NamDHay/DongTamV2/Hardware/dongtam.kicad_pcb

## KiCad design Hardware/dongtam.kicad_pcb (2023-11-13)

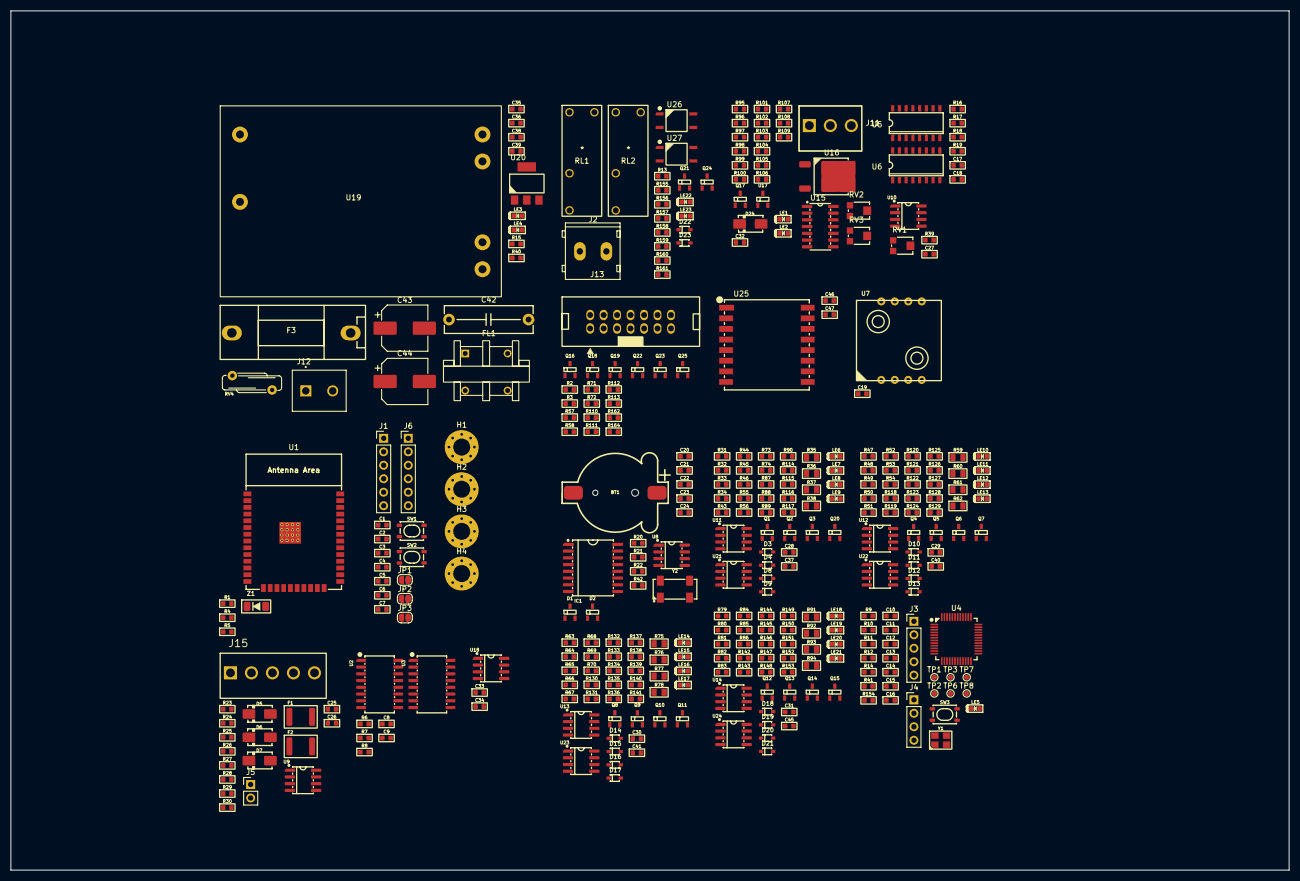
[picture p2: board dongtam.kicad_pcb from above]

Board: 2 copper layers, 241.0 x 162.0 mm, 350 parts (0 on the bottom side), 208 nets, no tracks yet.

Parts:
BT1: CR1220; BatteryHolder_CR1220
C1, C23: 10uF; C_0603
C2, C25, C33, C35, C38, C46: 1uF; C_0603
C3, C6, C7, C8, C9, C13, C14, C15, C16, C17, C18, C19, C22, C24, C26, C27, C28, C29, C30, C31, C32, C34, C36, C37, C39, C40, C41, C45, C47: 100nF; C_0603
C4: 33pF; C_0603
C5, C20, C21: 10pF; C_0603
C10, C11: 22pF; C_0603
C12: 10nF; C_0603
C42: C; C_Rect_L16.5mm_W5.0mm_P15.00mm_MKT
C43, C44: 100uF; CP_Elec_8x10.5
D1, D2: BAT54C; SOT23-3
D3, D4, D8, D9, D10, D11, D12, D13, D14, D15, D16, D17, D18, D19, D20, D21, D22, D23: 1N4007; D_SOD323
D5, D6, D7: D_TVS; D_SMA
D24: 1N4007; D_SMA
F1, F2: Polyfuse; Fuse_1812_4532Metric
F3: Fuse; Fuse_BLX-A-P22.4mm
FL1: Filter_EMI_LL; ACFilterChokeUU9.8
H1, H2, H3, H4: MountingHole; MountingHole_3.2mm_M3_Pad_Via
IC1: RTC_DS3231M; SOIC-16W_7.5x10.3mm_P1.27mm
J1, J6: Conn_01x05_Male; PinHeader_1x06_P2.54mm_Vertical
J2: Conn_01x02_Socket; KF128-5.0-2P
J3: Conn_01x05_Male; PinHeader_1x05_P2.54mm_Vertical
J4: Conn_01x04_Male; PinHeader_1x04_P2.54mm_Vertical
J5: Conn_01x02_Male; PinHeader_1x02_P2.54mm_Vertical
J11: HT3.96mm-3P; Terminal_HT-P3.96mm-3P-Vertical-Pluggable
J12: HT-5.08mm; KF-5.08mm
J13: IDC_02x07; DC3_14PIN_2.54mm
J15: Conn_01x05_Pin; Terminal_HT-3.96mm-5P-Vertical-Pluggable
JP1, JP2, JP3: SolderJumper-2_P1.3mm_Open_RoundedPad1.0x1.5mm
LE1, LE2, LE3, LE4, LE5, LE6, LE7, LE8, LE9, LE10, LE11, LE12, LE13, LE14, LE15, LE16, LE17, LE18, LE19, LE20, LE21, LE22, LE23: Led; LED_0603
Q1, Q2, Q3, Q4, Q5, Q6, Q7, Q8, Q9, Q10, Q11, Q12, Q13, Q14, Q15, Q16, Q18, Q19, Q20, Q21, Q22, Q23, Q24, Q25: N_Mosfet; SOT23-3
Q17: NPN; SOT23-3
R1: 100; R_0603
R2, R3, R6, R7, R8, R10, R11, R16, R17, R18, R19, R57, R58, R71, R72, R110, R111, R112, R113, R162, R164: 4k7; R_0603
R4, R5, R9, R15, R25, R26, R44, R46, R73, R87, R97, R118, R120, R122, R124, R130, R132, R134, R136, R142, R144, R146, R148: 10k; R_0603
R12: 2k2; R_0603
R13, R39, R40, R42, R43, R45, R47, R48, R49, R50, R55, R56, R63, R64, R65, R66, R74, R79, R80, R81, R82, R88, R89, R90, R96, R114, R115, R116, R117, R119, R121, R123, R125, R126, R127, R128, R129, R131, R133, R135, R137, R138, R139, R140, R141, R143, R145, R147, R149, R150, R151, R152, R153, R157: 1k; R_0603
R14, R154: 10K; R_0603
R20, R22: NC; R_0603
R21: 0R; R_0603
R23, R24, R27, R28, R29: 120R; R_0603
R30, R31, R32, R33, R34, R41, R51, R52, R53, R54, R67, R68, R69, R70, R83, R84, R85, R86, R155, R156: 1M; R_0603
R35, R36, R37, R38, R59, R60, R61, R62, R75, R76, R77, R78, R91, R92, R93, R94: 0R5; R_0805
R95: 220R; R_0603
R98: 560R; R_0603
R99, R100: 100k; R_0603
R101, R102, R103, R104, R105, R106, R109: 820k; R_0603
R107: 100R; R_0603
R108: 680k; R_0603
R158, R161: 5k; R_0603
R159, R160: R; R_0603
RL1, RL2: Relay_G5NB-1A-E_DC5; Relay_G5NB-1A-E DC5
RV1: TC33X_10k; Potentiometer_Bourns_TC33X_Vertical
RV2, RV3: 100k; Potentiometer_Bourns_TC33X_Vertical
RV4: Varistor; RV_Disc_D12mm_W5.8mm_P7.5mm
SW1, SW2, SW3: SW_Push; SW_SPST_PTS810
TP1, TP2, TP3, TP6, TP7, TP8: TestPoint; TestPoint_Pad_D1.0mm
U1: ESP32-WROOM-32UE; ESP32-WROOM-32E
U2, U3: 74HC165; SOIC-16W_5.3x10.2mm_P1.27mm
U4: STM32F103C8Tx; LQFP-48_7x7mm_P0.5mm
U5, U6: 74HC595; SOIC-16W_3.92x10.2mm
U7: AMS5915
U8: PCF8563TS; SOIC-8_3.9x4.9mm_P1.27mm
U9: SP3485EN; SOIC-8_3.9x4.9mm_P1.27mm
U10: MCP41010; SOIC-8_3.9x4.9mm_P1.27mm
U11, U12, U13, U14, U21, U22, U23, U24: LM393; SOIC-8_3.9x4.9mm_P1.27mm
U15: LM324; SOIC14
U16: LM317_TO-252; TO-252-2
U17: TL431; SOT23-3
U18: 24LC256; SOIC-8_3.9x4.9mm_P1.27mm
U19: AM22-24W2405V; DualPowerSupply_AM22-24W2405V
U20: LD1117; SOT233
U25: Ai-Thinker-Ra-02; MODULE_RA-02_LORA
U26, U27: Opto; OPTO_EL357N-G
Y1: 8MHz; Crystal_3225_4P_3.2x2.6mm
Y2: 32.768kHz; Crystal_MC306
Z1: D_Zener; D_MiniMELF

Connections:
+3V3: C8.2, C9.2, C13.1, C14.1, C15.1, C16.1, C19.2, C23.2, C24.2, C25.2, C27.1, C28.1, C29.1, C30.1, C31.1, C33.1, C34.1, C37.1, C38.2, C39.2, C40.1, C41.1, C45.1, C46.1, C47.1, D2.1, IC1.2 (VCC), J1.6, J3.4, J4.3, J6.6, J13.13, JP1.1 (A), LE5.1, Q16.1 (G), Q18.1 (G), Q19.1 (G), Q22.1 (G), Q23.1 (G), Q25.1 (G), R3.1, R4.1, R5.1, R6.1, R7.1, R8.1, R9.1, R10.1, R11.1, R26.1, R42.1, R44.1, R45.2, R46.1, R56.2, R57.1, R58.1, R73.1, R87.1, R89.2, R90.2, R110.1, R111.1, R118.1, R120.1, R122.1, R124.1, R126.2, R127.2, R128.2, R129.2, R130.1, R132.1, R134.1, R136.1, R138.2, R139.2, R140.2, R141.2, R142.1, R144.1, R146.1, R148.1, R150.2, R151.2, R152.2, R153.2, R159.2, R160.2, R162.1, RV1.3, U2.16 (VCC), U3.16 (VCC), U4.9 (VDDA), U4.24 (VDD), U4.36 (VDD), U4.48 (VDD), U7.2 (VCC), U9.8 (VCC), U10.5 (PA0), U10.8 (VDD), U11.8 (V+), U12.8 (V+), U13.8 (V+), U14.8 (V+), U18.8 (VCC), U20.2 (VO), U21.8 (V+), U22.8 (V+), U23.8 (V+), U24.8 (V+), U25.3 (VDD)
+5V: C17.2, C18.2, C35.2, C36.2, C44.1, D22.2, D23.2, J3.5, J13.2, R2.1, R16.1, R17.1, R18.1, R19.1, R22.1, R40.1, R71.1, R72.1, R112.1, R113.1, R157.1, R164.1, RL2.1, U5.10 (~SRCLR), U5.16 (VCC), U6.10 (~SRCLR), U6.16 (VCC), U19.6 (+5V), U20.3 (VI)
+24V: C43.1, D3.2, D4.2, D8.2, D9.2, D10.2, D11.2, D12.2, D13.2, D14.2, D15.2, D16.2, D17.2, D18.2, D19.2, D20.2, D21.2, R15.1, U19.3 (+24V)
/4-20mAConverter/DAC_4_20mA: R99.1, U1.10 (IO25), U15.3 (+)
/4-20mAConverter/LM137_IN: C32.1, D24.2, Q17.3 (C), U15.4 (V+), U16.3 (VI)
/4-20mAConverter/LM137_OUT: R95.1, R97.1, R98.2, U16.2 (VO)
/4-20mAConverter/TransB: Q17.1 (B), U15.8
/16_VALVE_CONTROL/595.RCLK: R19.2, U4.18 (PB0), U5.12 (RCLK), U6.12 (RCLK)
/16_VALVE_CONTROL/595.SER: R18.2, U4.17 (PA7), U5.14 (SER)
/16_VALVE_CONTROL/595.SRCLK: R17.2, U4.15 (PA5), U5.11 (SRCLK), U6.11 (SRCLK)
/16_VALVE_CONTROL/OE: R16.2, U2.15 (~CE), U3.15 (~CE), U4.33 (PA12), U5.13 (~OE), U6.13 (~OE)
/16_VALVE_CONTROL/VI_1: Q20.1 (G), R31.1, R114.1, U5.15 (QA)
/16_VALVE_CONTROL/VI_2: Q1.1 (G), R32.1, R115.1, U5.1 (QB)
/16_VALVE_CONTROL/VI_3: Q2.1 (G), R33.1, R116.1, U5.2 (QC)
/16_VALVE_CONTROL/VI_4: Q3.1 (G), R34.1, R117.1, U5.3 (QD)
/16_VALVE_CONTROL/VI_5: Q4.1 (G), R47.1, R51.1, U5.4 (QE)
/16_VALVE_CONTROL/VI_6: Q5.1 (G), R49.1, R52.1, U5.5 (QF)
/16_VALVE_CONTROL/VI_7: Q6.1 (G), R48.1, R53.1, U5.6 (QG)
/16_VALVE_CONTROL/VI_8: Q7.1 (G), R50.1, R54.1, U5.7 (QH)
/16_VALVE_CONTROL/VI_9: Q8.1 (G), R63.1, R67.1, U6.15 (QA)
/16_VALVE_CONTROL/VI_10: Q9.1 (G), R65.1, R68.1, U6.1 (QB)
/16_VALVE_CONTROL/VI_11: Q10.1 (G), R64.1, R69.1, U6.2 (QC)
/16_VALVE_CONTROL/VI_12: Q11.1 (G), R66.1, R70.1, U6.3 (QD)
/16_VALVE_CONTROL/VI_13: Q12.1 (G), R79.1, R83.1, U6.4 (QE)
/16_VALVE_CONTROL/VI_14: Q13.1 (G), R81.1, R84.1, U6.5 (QF)
/16_VALVE_CONTROL/VI_15: Q14.1 (G), R80.1, R85.1, U6.6 (QG)
/16_VALVE_CONTROL/VI_16: Q15.1 (G), R82.1, R86.1, U6.7 (QH)
/EEPROM/24256.SCL: Q19.2 (S), R111.2, U1.36 (IO22), U18.6 (SCL)
/EEPROM/24256.SDA: Q18.2 (S), R110.2, U1.33 (IO21), U18.5 (SDA)
/ESP32/BOOT: C6.1, J1.5, R4.2, SW1.1, U1.25 (IO0)
/ESP32/BT.s1: J13.11, U1.7 (IO35)
/ESP32/BT.s2: J13.9, U1.6 (IO34)
/ESP32/BT.s3: J13.7, U1.5 (SENSOR_VN)
/ESP32/BT.s4: J13.5, U1.4 (SENSOR_VP)
/ESP32/ESP_74595.RCLK: Q22.2 (S), R57.2, U1.29 (IO5)
/ESP32/ESP_74595.SER: Q16.2 (S), R3.2, U1.37 (IO23)
/ESP32/ESP_74595.SRCLK: Q23.2 (S), R58.2, U1.30 (IO18)
/ESP32/RST: C7.1, J1.2, R5.2, SW2.2, U1.3 (EN)
/ESP32/RX: J1.4, U1.34 (RXD0/IO3)
/ESP32/RX_ESP32: JP2.2 (B), U4.30 (PA9)
/ESP32/TCK: J6.4, U1.16 (IO13)
/ESP32/TDI: J6.2, U1.14 (IO12)
/ESP32/TDO: J6.3, U1.23 (IO15)
/ESP32/TMS: J6.5, U1.13 (IO14)
/ESP32/TX: J1.3, U1.35 (TXD0/IO1)
/ESP32/TX_ESP32: JP3.2 (B), U4.31 (PA10)
/ESP32/VDD_ESP32: C1.1, C2.1, C3.1, C4.1, C5.1, JP1.2 (B), U1.2 (VDD), Z1.2
/GET_16_VALVE_STAGE/74HC165.DATA: R6.2, U2.9 (Q7), U4.39 (PB3)
/GET_16_VALVE_STAGE/74HC165.LOAD: R8.2, U2.1 (~PL), U3.1 (~PL), U4.32 (PA11)
/GET_16_VALVE_STAGE/74HC165.SCK: R7.2, U2.2 (CP), U3.2 (CP), U4.40 (PB4)
/GET_16_VALVE_STAGE/MCP41010.CS: U4.25 (PB12), U10.1 (~CS)
/GET_16_VALVE_STAGE/MCP41010.MOSI: U4.28 (PB15), U10.3 (SI), U25.14 (MOSI)
/GET_16_VALVE_STAGE/MCP41010.SCK: U4.26 (PB13), U10.2 (SCK), U25.12 (SCK)
/GET_16_VALVE_STAGE/OPAMP/1_TL084IPT/VAN1-: D8.1, Q20.3 (D)
/GET_16_VALVE_STAGE/OPAMP/1_TL084IPT/VAN2-: D9.1, Q1.3 (D)
/GET_16_VALVE_STAGE/OPAMP/1_TL084IPT/VAN3-: D3.1, Q2.3 (D)
/GET_16_VALVE_STAGE/OPAMP/1_TL084IPT/VAN4-: D4.1, Q3.3 (D)
/GET_16_VALVE_STAGE/OPAMP/2_TL084IPT/VAN1-: D10.1, Q4.3 (D)
/GET_16_VALVE_STAGE/OPAMP/2_TL084IPT/VAN2-: D11.1, Q5.3 (D)
/GET_16_VALVE_STAGE/OPAMP/2_TL084IPT/VAN3-: D12.1, Q6.3 (D)
/GET_16_VALVE_STAGE/OPAMP/2_TL084IPT/VAN4-: D13.1, Q7.3 (D)
/GET_16_VALVE_STAGE/OPAMP/3_TL084IPT/VAN1-: D14.1, Q8.3 (D)
/GET_16_VALVE_STAGE/OPAMP/3_TL084IPT/VAN2-: D15.1, Q9.3 (D)
/GET_16_VALVE_STAGE/OPAMP/3_TL084IPT/VAN3-: D16.1, Q10.3 (D)
/GET_16_VALVE_STAGE/OPAMP/3_TL084IPT/VAN4-: D17.1, Q11.3 (D)
/GET_16_VALVE_STAGE/OPAMP/4_TL084IPT/VAN1-: D18.1, Q12.3 (D)
/GET_16_VALVE_STAGE/OPAMP/4_TL084IPT/VAN2-: D19.1, Q13.3 (D)
/GET_16_VALVE_STAGE/OPAMP/4_TL084IPT/VAN3-: D20.1, Q14.3 (D)
/GET_16_VALVE_STAGE/OPAMP/4_TL084IPT/VAN4-: D21.1, Q15.3 (D)
/GET_16_VALVE_STAGE/OPAMP/PW0_MCP41010: R39.1, R43.1, R44.2, R46.2, R55.1, R73.2, R74.1, R87.2, R88.1, R118.2, R119.1, R120.2, R121.1, R122.2, R123.1, R124.2, R125.1, R130.2, R131.1, R132.2, R133.1, R134.2, R135.1, R136.2, R137.1, R142.2, R143.1, R144.2, R145.1, R146.2, R147.1, R148.2, R149.1, RV1.2, U10.6 (PW0), U11.2 (-), U11.6 (-), U12.2 (-), U12.6 (-), U13.2 (-), U13.6 (-), U14.2 (-), U14.6 (-), U21.2 (-), U21.6 (-), U22.2 (-), U22.6 (-), U23.2 (-), U23.6 (-), U24.2 (-), U24.6 (-)
/GET_16_VALVE_STAGE/OPAMP/VO_1: R56.1, U2.11 (D0), U11.1
/GET_16_VALVE_STAGE/OPAMP/VO_2: R45.1, U2.12 (D1), U11.7
/GET_16_VALVE_STAGE/OPAMP/VO_3: R89.1, U2.13 (D2), U21.1
/GET_16_VALVE_STAGE/OPAMP/VO_4: R90.1, U2.14 (D3), U21.7
/GET_16_VALVE_STAGE/OPAMP/VO_5: R126.1, U2.3 (D4), U12.1
/GET_16_VALVE_STAGE/OPAMP/VO_6: R128.1, U2.4 (D5), U12.7
/GET_16_VALVE_STAGE/OPAMP/VO_7: R127.1, U2.5 (D6), U22.1
/GET_16_VALVE_STAGE/OPAMP/VO_8: R129.1, U2.6 (D7), U22.7
/GET_16_VALVE_STAGE/OPAMP/VO_9: R138.1, U3.11 (D0), U13.1
/GET_16_VALVE_STAGE/OPAMP/VO_10: R140.1, U3.12 (D1), U13.7
/GET_16_VALVE_STAGE/OPAMP/VO_11: R139.1, U3.13 (D2), U23.1
/GET_16_VALVE_STAGE/OPAMP/VO_12: R141.1, U3.14 (D3), U23.7
/GET_16_VALVE_STAGE/OPAMP/VO_13: R150.1, U3.3 (D4), U14.1
/GET_16_VALVE_STAGE/OPAMP/VO_14: R152.1, U3.4 (D5), U14.7
/GET_16_VALVE_STAGE/OPAMP/VO_15: R151.1, U3.5 (D6), U24.1
/GET_16_VALVE_STAGE/OPAMP/VO_16: R153.1, U3.6 (D7), U24.7
/IDC14pin/74595OE: Q25.2 (S), R162.2
/IDC14pin/74595_OE: J13.8, Q25.3 (D), R164.2
/IDC14pin/IC74595_RCLK: J13.10, Q22.3 (D), R71.2
/IDC14pin/IC74595_SER: J13.6, Q16.3 (D), R2.2
/IDC14pin/IC74595_SRCLK: J13.12, Q23.3 (D), R72.2
/IDC14pin/LCD_I2C_LOGIC_SCL: J13.3, Q19.3 (D), R113.2
/IDC14pin/LCD_I2C_LOGIDC_SDA: J13.4, Q18.3 (D), R112.2
/LORA/LORA_CS: U4.27 (PB14), U25.15 (~NSS)
/LORA/LORA_INT: U4.38 (PA15), U25.5 (DIO0)
/LORA/LORA_RST: U4.10 (PA0), U25.4 (~RESET)
/PRESSURE_SENSOR/i2c.SCL: IC1.16 (SCL), R10.2, U4.42 (PB6), U7.4 (SCL), U8.6 (SCL)
/PRESSURE_SENSOR/i2c.SDA: IC1.15 (SDA), R11.2, U4.43 (PB7), U7.3 (SDA), U8.5 (SDA)
/RELAY_OPTO/OPTO1: J2.1, R158.2, R159.1, U26.4
/RELAY_OPTO/OPTO2: J2.2, R160.1, R161.2, U27.4
/RELAY_OPTO/RL1: Q21.1 (G), R155.1
/RELAY_OPTO/RL2: Q24.1 (G), R156.1
/RS485/A1_RS485: D5.2, D6.1, F1.1, R27.2, R29.1
/RS485/A2_RS485: R26.2, R27.1, U9.6 (A)
/RS485/A_RS485: F1.2, J15.4, J15.5
/RS485/B1_RS485: D6.2, D7.1, F2.1, J5.1, R28.2
/RS485/B2_RS485: R25.1, R28.1, U9.7 (B)
/RS485/B_RS485: F2.2, J15.2, J15.3
/RS485/RS485.DERE: U4.11 (PA1), U9.2 (~RE), U9.3 (DE)
/RS485/RS485.RX: R24.1, U4.12 (PA2)
/RS485/RS485.TX: R23.1, U4.13 (PA3)
/RTC/Vbat: BT1.1 (+), D1.2, D2.3, R20.2, R21.1
/STM32F103C8T6/LED: R12.1, U4.19 (PB1)
/STM32F103C8T6/PD0: C10.2, R41.1, U4.5 (PD0), Y1.1
/STM32F103C8T6/PD1: C11.1, R41.2, U4.6 (PD1), Y1.3
/STM32F103C8T6/RST: C12.2, R9.2, SW3.1, U4.7 (NRST)
/STM32F103C8T6/RX_LOG: J4.2, U4.22 (PB11)
/STM32F103C8T6/SWCLK: J3.1, U4.37 (PA14)
/STM32F103C8T6/SWDIO: J3.2, U4.34 (PA13)
/STM32F103C8T6/TX_LOG: J4.1, U4.21 (PB10)
Earth: C26.1, J15.1, R30.1
GND: BT1.2 (-), C1.2, C2.2, C3.2, C4.2, C5.2, C6.2, C7.2, C8.1, C9.1, C10.1, C11.2, C12.1, C13.2, C14.2, C15.2, C16.2, C17.1, C18.1, C19.1, C20.2, C21.2, C22.2, C23.1, C24.1, C25.1, C26.2, C27.2, C28.2, C29.2, C30.2, C31.2, C32.2, C33.2, C34.2, C35.1, C36.1, C37.2, C38.1, C39.1, C40.2, C41.2, C43.2, C44.2, C45.2, C46.2, C47.2, D5.1, D7.2, IC1.5 (GND), IC1.6 (GND), IC1.7 (GND), IC1.8 (GND), IC1.9 (GND), IC1.10 (GND), IC1.11 (GND), IC1.12 (GND), IC1.13 (GND), J1.1, J3.3, J4.4, J6.1, J11.1, J13.1, J13.14, LE1.2, LE3.2, LE4.2, LE6.2, LE7.2, LE8.2, LE9.2, LE10.2, LE11.2, LE12.2, LE13.2, LE14.2, LE15.2, LE16.2, LE17.2, LE18.2, LE19.2, LE20.2, LE21.2, Q21.2 (S), Q24.2 (S), R14.1, R25.2, R30.2, R31.2, R32.2, R33.2, R34.2, R35.2, R36.2, R37.2, R38.2, R39.2, R43.2, R51.2, R52.2, R53.2, R54.2, R55.2, R59.2, R60.2, R61.2, R62.2, R67.2, R68.2, R69.2, R70.2, R74.2, R75.2, R76.2, R77.2, R78.2, R83.2, R84.2, R85.2, R86.2, R88.2, R91.2, R92.2, R93.2, R94.2, R96.2, R99.2, R103.2, R104.2, R119.2, R121.2, R123.2, R125.2, R131.2, R133.2, R135.2, R137.2, R143.2, R145.2, R147.2, R149.2, R154.1, R155.2, R156.2, RV1.1, RV2.3, RV3.3, SW1.2, SW2.1, SW3.2, U1.1 (GND), U1.15 (GND), U1.38 (GND), U1.39 (GND), U2.8 (GND), U3.8 (GND), U4.8 (VSSA), U4.23 (VSS), U4.35 (VSS), U4.47 (VSS), U5.8 (GND), U6.8 (GND), U7.1 (GND), U8.4 (VSS), U9.5 (GND), U10.4 (VSS), U10.7 (PB0), U11.4 (V-), U12.4 (V-), U13.4 (V-), U14.4 (V-), U15.11 (V-), U17.3 (A), U18.1 (A0), U18.2 (A1), U18.3 (A2), U18.4 (GND), U18.7 (WP), U19.4 (GND), U19.5 (GND), U20.1 (GND), U21.4 (V-), U22.4 (V-), U23.4 (V-), U24.4 (V-), U25.1 (GND), U25.2 (GND), U25.9 (GND), U25.16 (GND), U26.2, U26.3, U27.2, U27.3, Y1.2, Y1.4, Y2.2, Y2.3, Z1.1
unnamed: C42.2, F3.2, FL1.3, RV4.2
unnamed: D1.1, R42.2
unnamed: D1.3, IC1.14 (VBAT)
unnamed: J5.2, R29.2
unnamed: J11.2, LE2.2
unnamed: F3.1, J12.1
unnamed: C42.1, FL1.1, J12.2, RV4.1
unnamed: JP2.1 (A), R1.2
unnamed: JP3.1 (A), U1.28 (IO17)
unnamed: LE1.1, R97.2
unnamed: LE2.1, R107.1, R109.2
unnamed: LE3.1, R15.2
unnamed: LE4.1, R40.2
unnamed: LE5.2, R12.2
unnamed: LE6.1, R114.2
unnamed: LE7.1, R115.2
unnamed: LE8.1, R116.2
unnamed: LE9.1, R117.2
unnamed: LE10.1, R47.2
unnamed: LE11.1, R48.2
unnamed: LE12.1, R49.2
unnamed: LE13.1, R50.2
unnamed: LE14.1, R63.2
unnamed: LE15.1, R64.2
unnamed: LE16.1, R65.2
unnamed: LE17.1, R66.2
unnamed: LE18.1, R79.2
unnamed: LE19.1, R80.2
unnamed: LE20.1, R81.2
unnamed: LE21.1, R82.2
unnamed: LE22.1, R13.2
unnamed: LE23.1, R157.2
unnamed: Q1.2 (S), R36.1, U11.5 (+)
unnamed: Q2.2 (S), R37.1, U21.3 (+)
unnamed: Q3.2 (S), R38.1, U21.5 (+)
unnamed: Q4.2 (S), R59.1, U12.3 (+)
unnamed: Q5.2 (S), R60.1, U12.5 (+)
unnamed: Q6.2 (S), R61.1, U22.3 (+)
unnamed: Q7.2 (S), R62.1, U22.5 (+)
unnamed: Q8.2 (S), R75.1, U13.3 (+)
unnamed: Q9.2 (S), R76.1, U13.5 (+)
unnamed: Q10.2 (S), R77.1, U23.3 (+)
unnamed: Q11.2 (S), R78.1, U23.5 (+)
unnamed: Q12.2 (S), R91.1, U14.3 (+)
unnamed: Q13.2 (S), R92.1, U14.5 (+)
unnamed: Q14.2 (S), R93.1, U24.3 (+)
unnamed: Q15.2 (S), R94.1, U24.5 (+)
unnamed: Q17.2 (E), R105.2, R107.2
unnamed: Q20.2 (S), R35.1, U11.3 (+)
unnamed: D22.1, LE22.2, Q21.3 (D), RL1.4
unnamed: D23.1, LE23.2, Q24.3 (D), RL2.4
unnamed: R13.1, RL1.1
unnamed: R100.1, RV2.1
unnamed: R101.1, RV3.2
unnamed: R106.2, R108.1, U15.7
unnamed: R158.1, U26.1
unnamed: R161.1, U27.1
unnamed: R1.1, U1.27 (IO16)
unnamed: U2.10 (DS), U3.9 (Q7)
unnamed: R14.2, U4.44 (BOOT0)
unnamed: TP8.1, U4.14 (PA4)
unnamed: TP7.1, U4.16 (PA6)
unnamed: TP6.1, U4.29 (PA8)
unnamed: R154.2, U4.20 (PB2)
unnamed: TP1.1, U4.41 (PB5)
unnamed: TP2.1, U4.45 (PB8)
unnamed: TP3.1, U4.46 (PB9)
unnamed: U5.9 (QH'), U6.14 (SER)
unnamed: C20.1, U8.1 (OSCI), Y2.1
unnamed: C21.1, U8.2 (OSCO), Y2.4
unnamed: C22.1, R21.2, R22.2, U8.8 (VDD)
unnamed: R20.1, U8.3 (~INT)
unnamed: R23.2, U9.4 (DI)
unnamed: R24.2, U9.1 (RO)
unnamed: RV3.1, U15.1, U15.2 (-)
unnamed: R101.2, R102.1, U15.5 (+)
unnamed: R103.1, R106.1, U15.6 (-)
unnamed: R108.2, R109.1, U15.10 (+)
unnamed: R104.1, R105.1, U15.9 (-)
unnamed: RV2.2, U15.12 (+)
unnamed: R102.2, U15.13 (-), U15.14
unnamed: R95.2, R96.1, U16.1 (ADJ)
unnamed: R98.1, R100.2, U17.1 (K), U17.2 (REF)
unnamed: FL1.2, U19.1 (L)
unnamed: FL1.4, U19.2 (N)
VCC: D24.1, J11.3
