NamDHay/DongTamV2/Code/DongTamV2.1/Core/Src/main.c

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
/* Includes ------------------------------------------------------------------*/
#include "main.h"

/* USER CODE BEGIN Includes */
#include "stdbool.h"
#include "stdio.h"
#include "stdlib.h"

#include "BoardParameter.h"
#include "MessageHandle.h"

/* USER CODE END Includes */

I2C_HandleTypeDef hi2c1;

TIM_HandleTypeDef htim2;

UART_HandleTypeDef huart1;
UART_HandleTypeDef huart3;
DMA_HandleTypeDef hdma_usart1_rx;
DMA_HandleTypeDef hdma_usart3_rx;

/* USER CODE BEGIN PV */

FlagGroup_t fUART,fMesg,f1;
int SetVan,ClearVan;
char uartEsp32Buffer[MAX_MESSAGE],uartLogBuffer[MAX_MESSAGE];
uint16_t uartEsp32RxSize,uartLogRxSize;
UART_HandleTypeDef *uartTarget;
char mesgRX[MAX_MESSAGE],mesgTX[MAX_MESSAGE];
MesgValRX mesgRxRet;
uint16_t timerArray[2];
char outputStr[50];
/* USER CODE END PV */

void SystemClock_Config(void);
static void MX_GPIO_Init(void);
static void MX_DMA_Init(void);
static void MX_USART1_UART_Init(void);
static void MX_USART3_UART_Init(void);
static void MX_I2C1_Init(void);
static void MX_TIM2_Init(void);
/* USER CODE BEGIN PFP */
void SetUp();
void ProcedureVan();
HAL_StatusTypeDef GetUartMessage(char *outputStr);
/* USER CODE END PFP */

/* USER CODE BEGIN 0 */
const char *TAG = "MAIN";

void HAL_I2C_MasterRxCpltCallback(I2C_HandleTypeDef *hi2c)
{
	if(hi2c->Instance == I2C1){

	}
}
void HAL_UARTEx_RxEventCallback(UART_HandleTypeDef *huart, uint16_t Size){
	if(huart->Instance == USART1){
		HAL_UARTEx_ReceiveToIdle_DMA(huart, (uint8_t*)uartEsp32Buffer, MAX_MESSAGE);
		uartEsp32RxSize = Size;
		SETFLAG(fUART,FLAG_UART_ESP_RX_DONE);
	}
	if(huart->Instance == USART3){
		HAL_UARTEx_ReceiveToIdle_DMA(huart, (uint8_t*)uartLogBuffer, MAX_MESSAGE);
		uartLogRxSize = Size;
		SETFLAG(fUART,FLAG_UART_LOG_RX_DONE);
	}
}



void HAL_TIM_PeriodElapsedCallback(TIM_HandleTypeDef *htim)
{
	if(htim->Instance == TIM2){
		VanProcedure state = Brd_GetVanProcState();
		uint32_t tArray;
		switch(state){
			case BRD_PULSE_TIME:
				tArray = Brd_GetTimerArray(0);
				tArray++;
				Brd_SetTimerArray(0, tArray);
			break;
			case BRD_INTERVAL_TIME:
				tArray = Brd_GetTimerArray(1);
				tArray++;
				Brd_SetTimerArray(1, tArray);
			break;
			case BRD_CYCLE_INTERVAL_TIME:
//				tArray = Brd_GetTimerArray(2);
//				tArray++;
//				Brd_SetTimerArray(2, tArray);
			break;
			default:

			break;
		}
	}
}



extern BoardParameter brdParam;
/* USER CODE END 0 */

/**
  * @brief  The application entry point.
  * @retval int
  */
int main(void)
{
  /* MCU Configuration--------------------------------------------------------*/

  /* Reset of all peripherals, Initializes the Flash interface and the Systick. */
  HAL_Init();

  /* Configure the system clock */
  SystemClock_Config();

  /* Initialize all configured peripherals */
  MX_GPIO_Init();
  MX_DMA_Init();
  MX_USART1_UART_Init();
  MX_USART3_UART_Init();
  MX_I2C1_Init();
  MX_TIM2_Init();
  /* USER CODE BEGIN 2 */
  SetUp();
  HAL_GPIO_WritePin(UserLED_GPIO_Port, UserLED_Pin, 1);
  HAL_TIM_Base_Start_IT(&htim2);
  uartTarget = &huart3;
  while(!uartTarget);
  brdParam.cycIntvTime = 2;
  brdParam.intervalTime = 10;
  brdParam.pulseTime = 60;
  Brd_SetTotalVan(2);
  /* USER CODE END 2 */

  /* Infinite loop */
  /* USER CODE BEGIN WHILE */
  while (1)
  {
	  if(!GetUartMessage(mesgRX)){
		  mesgRxRet = MessageRxHandle(mesgRX,mesgTX);
		  if((HAL_StatusTypeDef)mesgRxRet != HAL_OK) {
			  HAL_UART_Transmit(uartTarget,(uint8_t*) mesgTX, strlen(mesgTX), HAL_MAX_DELAY);
			  char *s = "Invalid message, do nothing\n";
			  HAL_UART_Transmit(uartTarget,(uint8_t*) s, strlen(s), HAL_MAX_DELAY);
		  }
		  else HAL_UART_Transmit(uartTarget, (uint8_t*) mesgTX, strlen(mesgTX), HAL_MAX_DELAY);
	  }
	  ProcedureTriggerVan(outputStr);
	  if(Brd_GetVanProcState() == BRD_PULSE_TIME){
		  // log pressure
		  HAL_UART_Transmit(uartTarget,(uint8_t*)outputStr, strlen(outputStr), HAL_MAX_DELAY);
	  }
	  if(Brd_GetVanProcState() == BRD_INTERVAL_TIME && Brd_GetHC165State()){
		  // log VanState
		  HAL_UART_Transmit(uartTarget,(uint8_t*)outputStr, strlen(outputStr), HAL_MAX_DELAY);
		  Brd_SetHC165State(false);
	  }
    /* USER CODE END WHILE */

    /* USER CODE BEGIN 3 */
  }
  /* USER CODE END 3 */
}

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
/* USER CODE BEGIN 4 */





/**
 * @brief Nếu có chuỗi nhận được từ port UART (ESP hoặc máy tính), copy chuỗi nhận được ra outputStr và reset bộ đệm
 * @param outputStr mảng chứa thông tin nhận được từ UART
 * @return
 */
HAL_StatusTypeDef GetUartMessage(char *outputStr)
{
	if(CHECKFLAG(fUART,FLAG_UART_ESP_RX_DONE)){
		uartTarget = &huart1;
		strcpy(mesgRX,uartEsp32Buffer);
		memset(uartEsp32Buffer,0,uartEsp32RxSize);
		CLEARFLAG(fUART,FLAG_UART_ESP_RX_DONE);
		return HAL_OK;
	}
	if(CHECKFLAG(fUART,FLAG_UART_LOG_RX_DONE)){
		uartTarget = &huart3;
		strcpy(mesgRX,uartLogBuffer);
		memset(uartLogBuffer,0,uartLogRxSize);
		CLEARFLAG(fUART,FLAG_UART_LOG_RX_DONE);
		return HAL_OK;
	}
	return HAL_ERROR;
}



void UartIdle_Init()
{
	HAL_UARTEx_ReceiveToIdle_DMA(&huart1, (uint8_t*)uartEsp32Buffer, MAX_MESSAGE);
	HAL_UARTEx_ReceiveToIdle_DMA(&huart3, (uint8_t*)uartLogBuffer, MAX_MESSAGE);
	__HAL_DMA_DISABLE_IT(&hdma_usart1_rx,DMA_IT_HT);
	__HAL_DMA_DISABLE_IT(&hdma_usart3_rx,DMA_IT_HT);
}

void hc595_SetUp()
{
	HC595* p595 = Brd_GetAddress_HC595();
	HC595_AssignPin(p595, GPIOA, GPIO_PIN_5, HC595_CLK);
	HC595_AssignPin(p595, GPIOA, GPIO_PIN_7, HC595_DS);
	HC595_AssignPin(p595, GPIOB, GPIO_PIN_0, HC595_LATCH);
	HC595_AssignPin(p595, GPIOA, GPIO_PIN_12,HC595_OE);
	HC595_SetTarget(p595);

	HC595_ClearByteOutput(0xffffffff);
	HC595_ShiftOut(NULL, 2, 1);
	HC595_EnableOutput();
}

void hc165_SetUp()
{
	HC165* p165 = Brd_GetAddress_HC165();
	HC165_AssignPin(p165, GPIOA, GPIO_PIN_11, HC165_PL);
	HC165_AssignPin(p165, GPIOB, GPIO_PIN_3, HC165_DATA);
	HC165_AssignPin(p165, GPIOA, GPIO_PIN_12, HC165_CE);
	HC165_AssignPin(p165, GPIOB, GPIO_PIN_4, HC165_CP);
}

void SetUp()
{
	AMS5915_Init(Brd_GetAddress_AMS5915(),&hi2c1);
	PCF8563_Init(Brd_GetAddress_PCF8563(),&hi2c1);
	PCF8563_StartClock();
	PCF8563_CLKOUT_SetFreq(CLKOUT_1_Hz);
	PCF8563_CLKOUT_Enable(1);
	UartIdle_Init();
	hc165_SetUp();
	hc595_SetUp();
	HAL_UART_Transmit(&huart1, (uint8_t*)"Hello ESP32\n", strlen("Hello ESP32\n"), HAL_MAX_DELAY);
}

/* USER CODE END 4 */
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
