NamDHay/DongTamV2/Code/DongTamV2.1/Core/Inc/main.h

#define _74HC595_CLK_Pin GPIO_PIN_5
#define _74HC595_CLK_GPIO_Port GPIOA
#define _74HC595_DATA_Pin GPIO_PIN_7
#define _74HC595_DATA_GPIO_Port GPIOA
#define _74HC595_STORE_Pin GPIO_PIN_0
#define _74HC595_STORE_GPIO_Port GPIOB
#define UserLED_Pin GPIO_PIN_1
#define UserLED_GPIO_Port GPIOB
#define _74HC165_LOAD_Pin GPIO_PIN_11
#define _74HC165_LOAD_GPIO_Port GPIOA
#define OE_Pin GPIO_PIN_12
#define OE_GPIO_Port GPIOA
#define _74HC165_DATA_Pin GPIO_PIN_3
#define _74HC165_DATA_GPIO_Port GPIOB
#define _74HC165_CLK_Pin GPIO_PIN_4
#define _74HC165_CLK_GPIO_Port GPIOB
