NamDHay/DongTamV2/Code/ESP32/main/main.c

#include "./main.h"

#include <stdio.h>

#include "./ShareVar.h"
#include "./UART.h"
#include "driver/dac.h"
#include "freertos/queue.h"
#include "freertos/event_groups.h"
#include "RTC_Format.h"
#include "MessageHandle/MessageHandle.h"
#include "GUI/GUI.h"
#include "freertos/FreeRTOS.h" 
#include "nvs_flash.h"
#include "nvs.h"
#include "esp_tls.h"
#include "esp_http_client.h"
#include "esp_mac.h"
#include "OnlineHandle/OnlineManage.h"

#define MAC_ADDR_SIZE 6

QueueHandle_t qLogTx,qSTM32Tx,qUartHandle,qSTM32Ready;
uart_port_t uartTarget;
TaskHandle_t taskCommon,taskUartHandleString;
uint8_t mac_address[6] = {0x00, 0x11, 0x22, 0x33, 0x44, 0x55};
uint8_t MAC_WIFI[6];



void SendStringToUART(QueueHandle_t q,char *s);
void InitProcess();
void Setup();
void STM32_Set_Default_Parameter(char *sOutput);
void STM32_Ready_GUI(char *s);



/**
 * @brief Vì dùng ESP_LOG tốn tài nguyên CPU và bộ nhớ, ảnh hưởng đến tốc độ chạy của task nên gửi sang task IDLE để 
 * giảm thiểu xử lý, sử dụng hàm uart_write_bytes để gửi,
 * Item trong Queue qLogTx là một con trỏ char* trỏ tới chuỗi cần gửi lên máy tính, 
 * sau đó free bộ nhớ mà con trỏ char* đó trỏ tới 
 * 
 */
void app_main(void)
{
    
    Setup();
    char *s = NULL;
    char sOutput[50] = {0};
    while (1) {
        if(xQueueReceive(qLogTx,&s,10/portTICK_PERIOD_MS)){
            uart_write_bytes(UART_NUM_0,s,strlen(s));
            free(s);
        }
        if(xQueueReceive(qSTM32Ready,&s,100/portTICK_PERIOD_MS)){
            ESP_LOGI("STM32 1st","%s",s);
            if(!strcmp(s, MESG_READY_STM32)){
                STM32_Set_Default_Parameter(sOutput); 
                STM32_Ready_GUI("STM32 ready");
                xEventGroupSetBits(evgUART,EVT_UART_STM32_READY);
                vTaskDelay(1000/portTICK_PERIOD_MS);
                GUI_ShowPointer();
                GUI_LoadPageAtInit();
            } else {
                STM32_Ready_GUI("Wait STM32 ready");
            } 
        }
    }
}

/**
 * @brief
 * 
*/
void STM32_Ready_GUI(char *s){
    LCDI2C_Clear();
    vTaskDelay(20/portTICK_PERIOD_MS);
    LCDI2C_Print(s,0,0);
    LedErrorWrite(0);
    HC595_ShiftOut(NULL,2,1);
}

/**
 * @brief Task xử lý chuỗi từ bên file UART.c gửi sang thông qua qUARTHandle,
 * các thao tác xử lý chuỗi sẽ thực hiện tại đây 
 * 
 * @param pvParameter Không dùng
 */
void UartHandleString(void *pvParameter)
{
    char *s=NULL;
    char sOutput[50] = {0};
    EventBits_t e;
    e = xEventGroupGetBits(evgUART);
    while(1){
        if(xQueueReceive(qUartHandle,&s,10/portTICK_PERIOD_MS))
        {
<<<<<<< HEAD
            if(uartTarget == UART_NUM_0){
                ESP_LOGI("PC","%s",s);
            }
            else if (uartTarget == UART_NUM_2){
                ESP_LOGI("STM32","%s",s);
            }
=======

            if(uartTarget == UART_NUM_0) ESP_LOGI("PC","%s",s);
            else if (uartTarget == UART_NUM_2) ESP_LOGI("STM32","%s",s);
>>>>>>> LCD_Reset

            if (!CHECKFLAG(e, EVT_UART_STM32_READY)){
                xQueueSend(qSTM32Ready,&s,portMAX_DELAY);
                e = xEventGroupWaitBits(evgUART,EVT_UART_STM32_READY,pdFALSE,pdFALSE,50/portTICK_PERIOD_MS);              
            }
            if(CHECKFLAG(e, EVT_UART_STM32_READY)){
                if(MessageRxHandle(s,sOutput) == ESP_OK){
                    if(uartTarget == UART_NUM_0){
                        SendStringToUART(qSTM32Tx,sOutput);
                        memset(sOutput,0,strlen(sOutput));
                    } else if(uartTarget == UART_NUM_2) {
                        SendStringToUART(qLogTx,s);
                        memset(sOutput,0,strlen(sOutput));
                    }
                } 
            }
            else ESP_LOGE("STM32v","Event bit not received");
            free(s);
        }
    }
}
void get_mac_wifi_address(){
    uint8_t mac[MAC_ADDR_SIZE];
    esp_read_mac(mac,ESP_MAC_WIFI_STA);
    ESP_LOGI("MAC address", "MAC address: %02x:%02x:%02x:%02x:%02x:%02x", mac[0], mac[1], mac[2], mac[3], mac[4], mac[5]);
}

void set_mac_address(uint8_t *mac){
    esp_err_t err = ESP_OK;
    if (err == ESP_OK) {
        ESP_LOGI("MAC address", "MAC address successfully set to %02x:%02x:%02x:%02x:%02x:%02x", mac[0], mac[1], mac[2], mac[3], mac[4], mac[5]);
    } else {
        ESP_LOGE("MAC address", "Failed to set MAC address");
    }
}


/**
 * @brief Khởi tạo bộ nhớ flash, khởi tạo vùng nhớ Queue, 
 * khởi tạo các ngoại vi liên quan tới GUI như LCD I2C, 
 * cấu hình chân HC595 cho LED bar hiển thị áp suất, 
 * cấu hình chân giao tiếp UART
 * Load các thông số board mặc định vào struct BoardParamter
 */
void InitProcess()
{
    // Initialize NVS
    esp_err_t err = nvs_flash_init();
    if (err == ESP_ERR_NVS_NO_FREE_PAGES || err == ESP_ERR_NVS_NEW_VERSION_FOUND) {
        // NVS partition was truncated and needs to be erased
        // Retry nvs_flash_init
        ESP_ERROR_CHECK(nvs_flash_erase());
        err = nvs_flash_init();
    }
    qLogTx = xQueueCreate(6,sizeof(char *));
    qUartHandle = xQueueCreate(6,sizeof(char *));
    qSTM32Tx = xQueueCreate(4,sizeof(char *));
    qSTM32Ready = xQueueCreate(1, strlen(MESG_READY_STM32));
    Brd_LoadDefaultValue();
    Brd_PrintAllParameter();
    UARTConfig();
    GuiInit();
}

void STM32_Set_Default_Parameter(char *sOutput){
    MesgValTX paramToSendSTM32[] = {
        TX_PULSE_TIME,
        TX_TOTAL_VAN,
        TX_CYC_INTV_TIME,
        TX_INTERVAL_TIME,
    };

    for(uint8_t i = 0; i < sizeof(paramToSendSTM32)/sizeof(MesgValTX); i++){
        MessageTxHandle(paramToSendSTM32[i], sOutput);
        SendStringToUART(qSTM32Tx,sOutput);
        ESP_LOGI("STM32v","%s",sOutput);
    }
}

/**
 * @brief Cấp phát vùng nhớ chứa chuỗi s cần gửi qua UART
 * 
 * @param q Hàng đợi tương ứng với bộ UART cần gửi, ví dụ qLogTx gửi lên UART để log data, 
 * qSTM32Tx để gửi xuống STM32
 * @param s Con trỏ trỏ tới chuỗi ký tự cần gửi đi
 */
void SendStringToUART(QueueHandle_t q,char *s)
{
    char *a = (char *) malloc(strlen(s) + cJSON_OFFSET_BYTES);
    if(a) {
        strcpy(a,s);
        xQueueSend(q,(void*)&a,2/portTICK_PERIOD_MS);
    }
    else ESP_LOGI("MAIN","Cannot malloc to send queue");
}

bool STM32_IsReady()
{
    EventBits_t e = xEventGroupGetBits(evgUART);
    if(e & EVT_UART_STM32_READY) return 1;
    return 0;
}


void Setup()
{
    i2cdev_init();
    TaskHandle_t *taskGUIHandle = GUI_GetTaskHandle();
    TaskHandle_t *taskOnlManage = TaskOnl_GetHandle();
    InitProcess();
    ESP_LOGI("Notify","pass InitProcess");
    xTaskCreate(TaskUart, "TaskUart", 2048, NULL, 3, NULL);
    xTaskCreate(UartHandleString,"UartHandleString",4096,NULL,2,NULL);
    xTaskCreate(GUITask, "GUITask", 4096, NULL, 2, taskGUIHandle);
    xTaskCreate(TaskScanButton, "TaskScanButton", 2048, NULL, 1, NULL);
    xTaskCreatePinnedToCore(TaskOnlManage,"TaskOnlManage",4096,NULL,3,taskOnlManage,1);

}
