NamDHay/DongTamV2/Code/ESP32/main/MessageHandle/MessageHandle.c

#include "MessageHandle.h"
#include "RTC_Format.h"
#include "../GUI/PressureIndicator.h"
#include "../GUI/LedButton.h"
#include "../BoardParameter.h"
#include "../ShareVar.h"
#include "OnlineHandle/OnlineManage.h"
#include "freertos/FreeRTOS.h"


const char* strRxKey[] = {
	// Receive message
	"Start",//START_INT_VALUE
	"VanState", // -> this is String match with STM32, do not modify
	// String below receive from PC, can be change 
	"totalVan",
	"dpHigh",
	"dpLow",
	"dpWarn",
	"pulseTime",
	"intTime",
	"cycIntTime",
	"readFlash",
	"saveFlash",
	"trigVan",
	"Float",//START_FLOAT_VALUE
	"P",
	"DoNothing",//START_TIME_FORMAT
	"CurrentTime",// -> this is String match with STM32, do not modify
	"End",
};

/**
 *  Tập lệnh gửi đi thông số board để phản hồi 
*/
const char* strTxKey[] = {
	// Transmit message
	"Start",
	"SetVan: ",
	"SetMultiVan: ",
	"ClearVan: ",
	"SetPulseTime: ",
	"SetTotalVan: ",
	"SetCycleIntervalTime: ",
	"TrigVan: ",
	"SetIntervalTime: ",
	"SetTime: ",
	"GetTime: ",
};

/**	
 * @brief Xử lý chuỗi nhận được, so sánh với các chuỗi đã có trong strRxKey
 * @param inputStr chuỗi cần xử lý
 * @param outputStr chuỗi trả về để thông báo kết quả xử lý
 * @return HAL_OK nếu xử lý thành công, HAL_ERROR nếu có lỗi xảy ra
 */
esp_err_t MessageRxHandle(char *inputStr, char* outputStr)
{
	uint8_t indexKey = sizeof(strRxKey)/sizeof(char*);
	for(uint8_t i=1;i < indexKey;i++){
		if(strstr(inputStr,strRxKey[i])){	
			return MesgGetValue(i,inputStr,outputStr);
		}
	}
	return ESP_ERR_INVALID_ARG;
}

esp_err_t MessageTxHandle(MesgValTX mesgValTX,char *outputStr)
{
	uint32_t val = 0;
	char s[30] = {0};
	switch (mesgValTX)
	{
	case TX_TOTAL_VAN:
		val = Brd_GetParamIntValue(INDEX_TOTAL_VAN);
		break;
	case TX_INTERVAL_TIME:
		val = Brd_GetParamIntValue(INDEX_INTERVAL_TIME);
		break;
	case TX_CYC_INTV_TIME:
		val = Brd_GetParamIntValue(INDEX_CYCLE_INTERVAL_TIME);
		break;
	case TX_PULSE_TIME:
		val = Brd_GetParamIntValue(INDEX_PULSE_TIME);
		break;
	case TX_TRIG_VAN:
		char *s;
		s = Brd_ConvertStringValueIndexToString(Brd_GetParamStringValueIndex(INDEX_TRIG_VAN));
		ESP_LOGI("TRIGVAN","ValStr:%s",s);
		LedErrorWrite(0);
		if(!strcmp(s,"On")){
			val = 1;
			LedStatusWrite(1);
		} else if(!strcmp(s,"Off")){
			val = 0;
			LedStatusWrite(0);
		} else return ESP_ERR_INVALID_ARG;
		HC595_ShiftOut(NULL,2,1);
		break;
	default:
		break;
	}
	sprintf(s,"%s%lu",strTxKey[mesgValTX],val);
	if(outputStr) strcpy(outputStr,s);
	else return ESP_ERR_INVALID_ARG;
	return ESP_OK; 
}



esp_err_t MesgGetValue(MesgValRX mesgValRX, char*inputStr,char *outputStr)
{

	RTC_t t;
	uint32_t val=0;
	float fVal=0;
	uint8_t itemConverted = 0;
	if(mesgValRX > RX_START_INT_VALUE && mesgValRX < RX_START_FLOAT_VALUE){
		itemConverted = sscanf(inputStr,MESG_PATTERN_KEY_VALUE_INT,&val);
		// check if value can be obtained from string
		if(itemConverted != 1) {
			if(outputStr) strcpy(outputStr,"--->Cannot parse value\n");
			return ESP_ERR_INVALID_ARG;
		}
	} else if (mesgValRX > RX_START_FLOAT_VALUE && mesgValRX < RX_START_TIME_FORMAT){
		itemConverted = sscanf(inputStr,MESG_PATTERN_KEY_VALUE_FLOAT,&fVal);
		// check if value can be obtained from string
		if(itemConverted != 1) {
			if(outputStr) strcpy(outputStr,"--->Cannot parse value\n");
			return ESP_ERR_INVALID_ARG;
		}
	} else if (mesgValRX > RX_START_TIME_FORMAT && mesgValRX < RX_END_MESSAGE){
		t = RTC_GetTimeFromString(inputStr);
	}
	switch (mesgValRX)
	{
	case RX_VANSTATE:
	if(!val) {
		LedErrorWrite(1);
		LedStatusWrite(0);
		HC595_ShiftOut(NULL,2,1);
	}
	break;
	case RX_TOTAL_VAN:
	Brd_SetParamInt(INDEX_TOTAL_VAN,val,NULL);
	MessageTxHandle(TX_TOTAL_VAN,outputStr);
	break;
	case RX_PULSE_TIME:
	Brd_SetParamInt(INDEX_PULSE_TIME,val,NULL);
	MessageTxHandle(TX_PULSE_TIME,outputStr);
	break;
	case RX_CYC_INTV_TIME:
	Brd_SetParamInt(INDEX_CYCLE_INTERVAL_TIME,val,NULL);
	MessageTxHandle(TX_CYC_INTV_TIME,outputStr);
	break;
	case RX_DP_HIGH:
	Brd_SetParamInt(INDEX_DP_HIGH,val,NULL);
	break;
	case RX_DP_LOW:
	Brd_SetParamInt(INDEX_DP_LOW,val,NULL);
	break;
	case RX_DP_WARN:
	Brd_SetParamInt(INDEX_DP_WARN,val,NULL);
	break;
	case RX_INTERVAL_TIME:
	Brd_SetParamInt(INDEX_INTERVAL_TIME,val,NULL);
	MessageTxHandle(TX_INTERVAL_TIME,outputStr);
	break;
	case RX_READ_FLASH:
	if(val) {
		Brd_ReadParamFromFlash();
		Brd_PrintAllParameter();
	}
	break;
	case RX_SAVE_FLASH:
	if(val) {
		esp_err_t err = ESP_OK;
		err = Brd_WriteParamToFlash();
		if(err != ESP_OK) ESP_LOGE("GetVal","err:%d",err);
		else ESP_LOGI("GetVal","err:%d",err);
	}
	else ESP_LOGI("GetVal","Are you kidding me?");
	break;
	case RX_TRIG_VAN:
		LedErrorWrite(0);
		LedStatusWrite(1);
		HC595_ShiftOut(NULL,2,1);
		ESP_LOGI("GetValue","TrigVan");
		TX_STM32_TrigVan(val);
	break;
	case RX_CURRENT_TIME:
		Brd_SetRTC(t);
		TaskHandle_t *taskOnlHandle = TaskOnl_GetHandle();
		if(taskOnlHandle) xTaskNotify(*taskOnlHandle,0x01,eSetValueWithoutOverwrite);
	break;
	case RX_PRESSURE: 
	PI_SetLevel(PI_CalcLevelFromPressure(fVal));
	Brd_SetPressure(fVal);
	break;
	default:
		break;
	}
	return ESP_OK;
}

void TX_STM32_TrigVan(uint8_t Trig)
{
	char s[20] = {0};
	if(Trig) {
		sprintf(s,"%s%u",strTxKey[TX_TRIG_VAN],Trig);
		SendStringToUART(qSTM32Tx,s);
	} else {
		sprintf(s,"%s%u",strTxKey[TX_TRIG_VAN],Trig);
		SendStringToUART(qSTM32Tx,s);
	}
}
