NamDHay/DongTamV2/Code/ESP32/main/main.h

#ifndef _MAIN_H_
#define _MAIN_H_

#include "freertos/FreeRTOS.h"
#include "freertos/task.h"
#include "esp_log.h"
#include "sdkconfig.h"
#include "freertos/queue.h"

#define cJSON_OFFSET_BYTES 5
#define NVS_SAVE_VAN_VALUE "FlashSaveVan" 
#define NVS_GET_VAN_VALUE "FlashReadVan" 
#define MESG_READY_STM32 "Hello ESP32\n"


#define CHECKFLAG(FlagGroup,FlagBit) ((((FlagGroup) & (FlagBit)) == (FlagBit)) ? 1 : 0) 


void SendStringToUART(QueueHandle_t q,char *s);
void UartHandleString(void *pvParameter);
bool STM32_IsReady();
#endif
