NamDHay/DongTamV2/Code/DongTamV2.1/Core/Inc/ShareVar.h

/*
 * ShareVar.h
 *
 *  Created on: May 22, 2023
 *      Author: SpiritBoi
 */

#ifndef INC_SHAREVAR_H_
#define INC_SHAREVAR_H_

#define FLAG_UART_ESP_RX_DONE (1<<0)
#define FLAG_UART_LOG_RX_DONE (1<<1)

#define FLAG_TRIG_VAN_PROCEDURE (1<<6)
#define FLAG_AFTER_TRIG_VAN_ON (1<<7)
#define FLAG_GET_PRESSURE_MAX_DONE (1 << 9)





#endif /* INC_SHAREVAR_H_ */
